tstrade/RoboFlock-Documentation/docs/source/hardware_docs/arduino.rst

Arduino Nano
============

.. include:: ../_templates/constants.rst

**Datasheet:** :raw-html:`<br />`
`Arduino Nano ATmega328 Microcontroller User Manual <nano_>`_

**Features:** 
16MHz Clock Frequency :raw-html:`<br />`
Digital, Analog, PWM, UART, I2C, and SPI Capabilities :raw-html:`<br />`
32kB Flash Memory :raw-html:`<br />`
2kB Internal SRAM :raw-html:`<br />`
1kB EEPROM :raw-html:`<br />`
Ideal for Constrained Spaces

**Connection:** :raw-html:`<br />`
Mini-B USB to USB Type-A 

**Interfacing:** :raw-html:`<br />`
`Arduino IDE <ide_>`_ 

**Dimensions (with headers):** :raw-html:`<br />`
43.2mm x 18mm x 18.5mm

**Use-Case:** :raw-html:`<br />`
Controls and processes data for all three :doc:`ultrasonic sensors <hc_sr04>`.

.. _nano: https://docs.arduino.cc/resources/datasheets/A000005-datasheet.pdf

.. _ide: https://docs.arduino.cc/software/ide/
