tstrade/RoboFlock-Documentation/docs/source/codebase_docs/codebase.rst

==================
RoboFlock Codebase
==================

.. toctree::
    :titlesonly:
    :hidden:
    :maxdepth: 1

    ultrasonic_code
    beacon_code
