tstrade/RoboFlock-Documentation/docs/source/citation_docs/glossary.rst

========
Glossary
========

.. include:: ../_templates/constants.rst

**GGA** - Global Positioning System Fix Data
:raw-html:`<br />`

**GLONASS** - Global Navigation Satellite System
:raw-html:`<br />`

**GNSS** - Global Navigation Satellite System
:raw-html:`<br />`

**GPS** - Global Positioning System
:raw-html:`<br />`

**IMU** - Inertial Measurement Unit
:raw-html:`<br />`

**LiDAR** - Light Detection and Ranging
:raw-html:`<br />`

**LoRa** - Long-Range Radio
:raw-html:`<br />`

**NMEA** - National Marine Electronics Association
:raw-html:`<br />`

**RF** - Radio Frequency
:raw-html:`<br />`

**ROS2** - Robot Operating System 2
:raw-html:`<br />`

**ToF** - Time-of-Flight
:raw-html:`<br />`
