tstrade/RoboFlock-Documentation/docs/source/citation_docs/appendix_b.rst

==========
Appendix B
==========

++++++++++
Datasheets
++++++++++

- `HC-12 Wireless RF UART Communication Module User Manual rev.2.4 <DS1_>`_

- `SLAMTEC RPLidar A1 Datasheet rev.2.1 <DS2_>`_

- `NVIDIA Jetson Orin Nano Series Modules Datasheet v1.5 <DS3_>`_

- `Jetson Nano Developer Kit User Guide v1.3 <DS4_>`_

- `Jetson Orin NX Series and Jetson Orin Nano Series Pin and Function Name Guide v1.0 <DS5_>`_

- `NEO-M8P-2 Datasheet <DS6_>`_

- `NEO-M8P-2 Hardware Integration Module <DS7_>`_

- `ANN-MB Series - Multi-Band, High Precision GNSS Antennas Datasheet rev.R05 <DS8_>`_

- `u-blox GNSS Multiband Antenna ANN-MB-00 (IP67) Datasheet <DS9_>`_

- `ZED-F9P-02B High-Precision GNSS Module (Professional Grade) Datasheet rev.R03 <DS10_>`_

- `LV-MaxSonar-EZ Series: High Performance Sonar Range Finder Datasheet <DS11_>`_

- `MAX17048/MAX17049 3uA 1-Cell/2-Cell Fuel Gauge with ModelGauge Datasheet rev.7 <DS12_>`_

- `Arduino Nano Datasheet rev.4 <DS13_>`_

- `iRhapsody 40/30A 12VDC Waterproof Relay Kit Instruction Manual <DS14_>`_

.. _DS1: https://statics3.seeedstudio.com/assets/file/bazaar/product/HC-12_english_datasheets.pdf

.. _DS2: https://cdn-shop.adafruit.com/product-files/4010/4010_datasheet.pdf

.. _DS3: https://developer.nvidia.com/downloads/assets/embedded/secure/jetson/orin_nano/docs/jetson_orin_nano_ds

.. _DS4: https://developer.nvidia.com/embedded/dlc/Jetson_Nano_Developer_Kit_User_Guide

.. _DS5: https://developer.nvidia.com/downloads/assets/embedded/secure/jetson/orin_nx/docs/jetson_orin_nx_orin_nano_pin_function_names_guide_da-11434-001_v1.0.pdf

.. _DS6: https://cdn.sparkfun.com/assets/2/f/6/8/3/NEO-M8P_DataSheet__UBX-15016656_.pdf

.. _DS7: https://cdn.sparkfun.com/assets/a/a/d/2/2/NEO-M8P_HardwareIntegrationManual__UBX-15028081_.pdf

.. _DS8: https://content.u-blox.com/sites/default/files/documents/ANN-MB_DataSheet_UBX-18049862.pdf

.. _DS9: https://www.ardusimple.com/wp-admin/admin-post.php?action=generate_product_pdf&product_id=3127 

.. _DS10: https://cdn.sparkfun.com/assets/f/8/d/6/d/ZED-F9P-02B_DataSheet_UBX-21023276.pdf

.. _DS11: https://cdn.shopify.com/s/files/1/0550/8091/0899/files/11832.pdf?v=1726578772

.. _DS12: https://www.analog.com/media/en/technical-documentation/data-sheets/max17048-max17049.pdf

.. _DS13: https://docs.arduino.cc/resources/datasheets/A000005-datasheet.pdf

.. _DS14: https://manuals.plus/asin/B074FSZWVT 

Schematics
^^^^^^^^^^

- `Qwiic GPS-RTK-SMA - u-blox ZED-F9P Schematic v12  <SC1_>`_

- `Qwiic GPS-RTK - u-blox NEO-M8P Schematic v10 <SC2_>`_

- `SLAMTEC RPLiDAR A1M8 Core Schematic <SC3_>`_

.. _SC1: https://cdn.sparkfun.com/assets/6/5/7/6/6/SparkFun-GPS-RTK-SMA-ZED-F9P-Schematic.pdf

.. _SC2: https://cdn.sparkfun.com/assets/f/f/5/c/8/Qwiic_GPS-RTK_-_ublox_NEO-M8P.pdf

.. _SC3: https://bucket-download.slamtec.com/fb0b36f64212432b51a8e078081f168f39b96a49/RPLIDAR%20A1M8_en.pdf
