tstrade/RoboFlock-Documentation/docs/source/description_docs/future_considerations.rst

Future Considerations
=====================

Return home functionality

Replace NEO with ZED

Location broadcasting

L5 GPS

4D LiDAR

Nvidia (ISAAC) ROS 2 Projects
