tstrade/RoboFlock-Documentation/docs/source/citation_docs/mathref_docs/kalmanfilters.rst

================
Kalman Filtering
================

Kalman Filter
+++++++++++++

Extended Kalman Filter
++++++++++++++++++++++

Unscented Kalman Filter
+++++++++++++++++++++++
