tstrade/RoboFlock-Documentation/docs/source/contact.rst

==========
Contact Us
==========

.. grid:: 2 2 3 4
    :gutter: 3

    .. grid-item-card::
        :class-title: sd-text-center
        :class-card: sd-shadow-sm

        **Thomas Strade** 
        ^^^
        *Primary Maintainer*
        +++
        📧 tstrade@buffalo.edu

        🐱 `@tstrade <https://github.com/tstrade>`_

    .. grid-item-card::
        :class-title: sd-text-center
        :class-card: sd-shadow-sm

        **Aditya Challamarad** 
        ^^^
        *Software Lead*
        +++
        🐱 `@Adityasc9 <https://github.com/Adityasc9>`_

    .. grid-item-card::
        :class-title: sd-text-center
        :class-card: sd-shadow-sm

        **Marco Bianco** 
        ^^^
        *Integration Lead*
        +++
        🐱 `@marcobia <https://github.com/Marcob1129>`_

    .. grid-item-card::
        :class-title: sd-text-center
        :class-card: sd-shadow-sm

        **Nicholas Pitsakis** 
        ^^^
        *Communications Lead*
        +++
        🐱 `@npitsakis <https://github.com/npitsakis>`_

    .. grid-item-card::
        :class-title: sd-text-center
        :class-card: sd-shadow-sm

        **Krish Puwar** 
        ^^^
        *Support Lead*
        +++
        🐱 `@krishpuw <https://github.com/krishpuw>`_

    .. grid-item-card::
        :class-title: sd-text-center
        :class-card: sd-shadow-sm

        **Shouvik Das** 
        ^^^
        *Testing Lead*
        +++
        🐱 `@shouvik-d <https://github.com/shouvik-d>`_

    .. grid-item-card::
        :class-title: sd-text-center
        :class-card: sd-shadow-sm

        **Andrew Collado** 
        ^^^
        *Design Lead*
        +++
        🐱 `@AndrewCollado <https://github.com/AndrewCollado>`_

.. admonition:: Get in Touch
    :class: tip

    - 🐛 **Report bugs or request features**: Open an issue on our `GitHub <https://github.com/shouvik-d/roboflock_ws>`_

    - 💬 **General quesions**: Email the primary maintainer
    
    - 📚 **Academic inquiries**: Contact the project lead
