tstrade/RoboFlock-Documentation/docs/source/photo_video.rst

================
Photo and Videos
================

.. include:: _templates/constants.rst

Isn't engineering just so... fun?

.. @todo: switch to sphinx-design, carousel was archived in 2024

.. carousel::
    :show_controls:

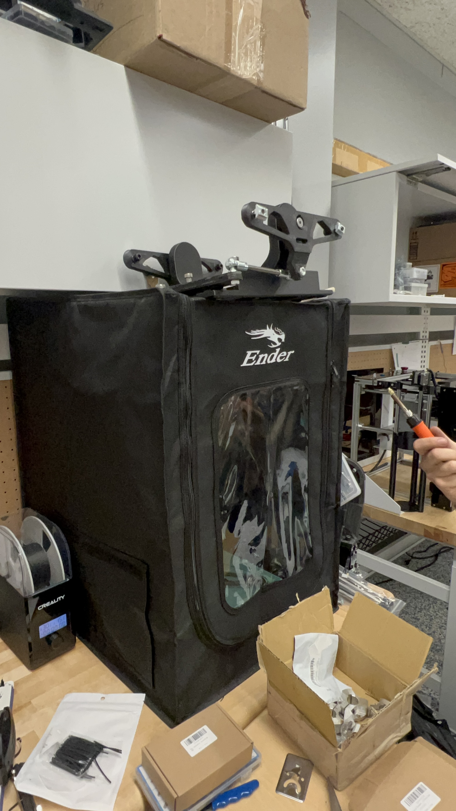
[picture p10: docs/source/_images/progress_album/IMG_5511.jpg]
    

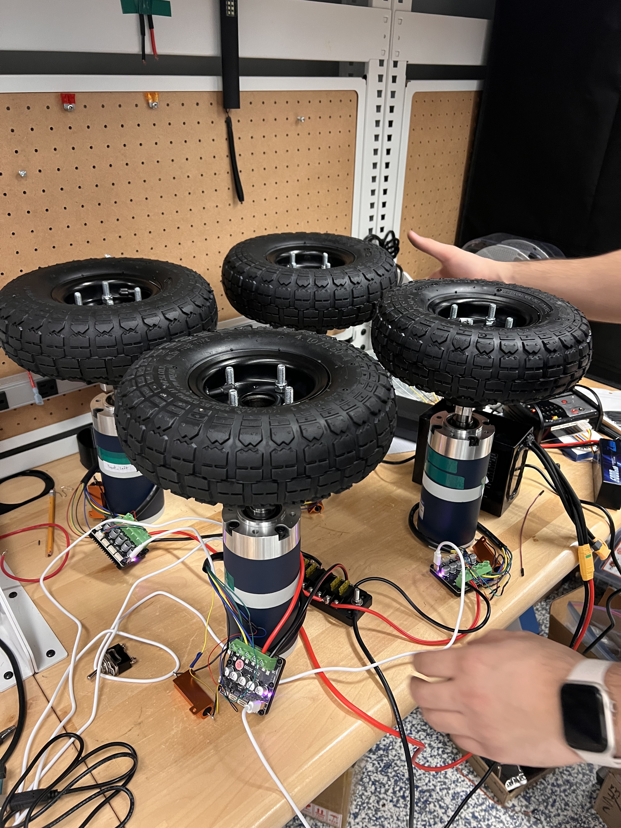
[picture p11: docs/source/_images/progress_album/IMG_5522.jpg]
    

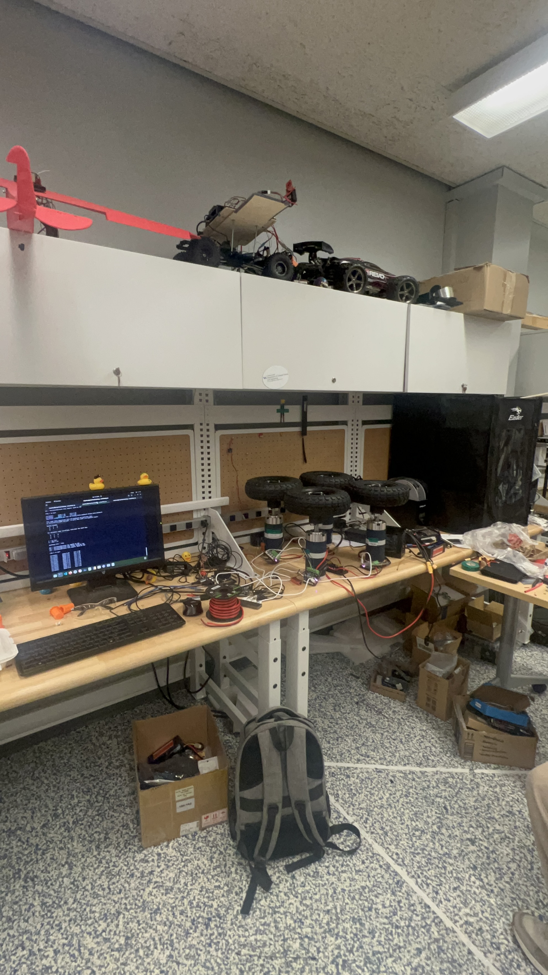
[picture p12: docs/source/_images/progress_album/IMG_5525.jpg]
    

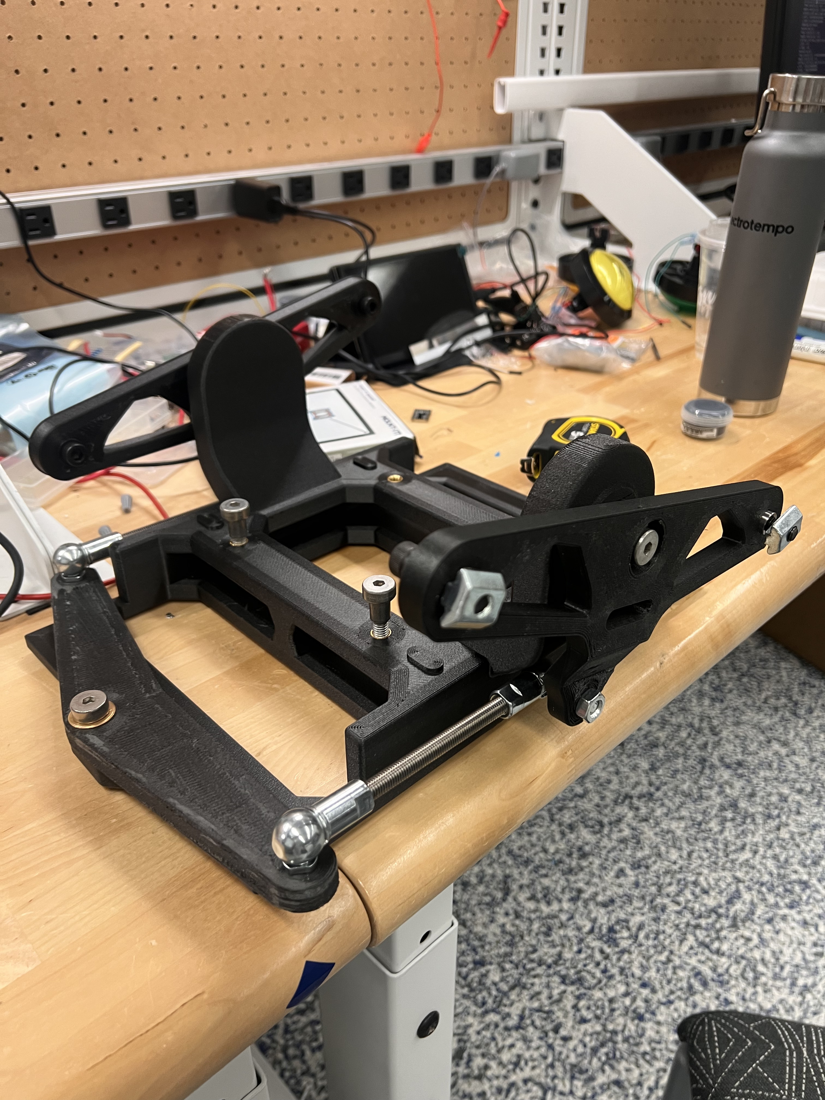
[picture p13: docs/source/_images/progress_album/IMG_5531.jpg]
    

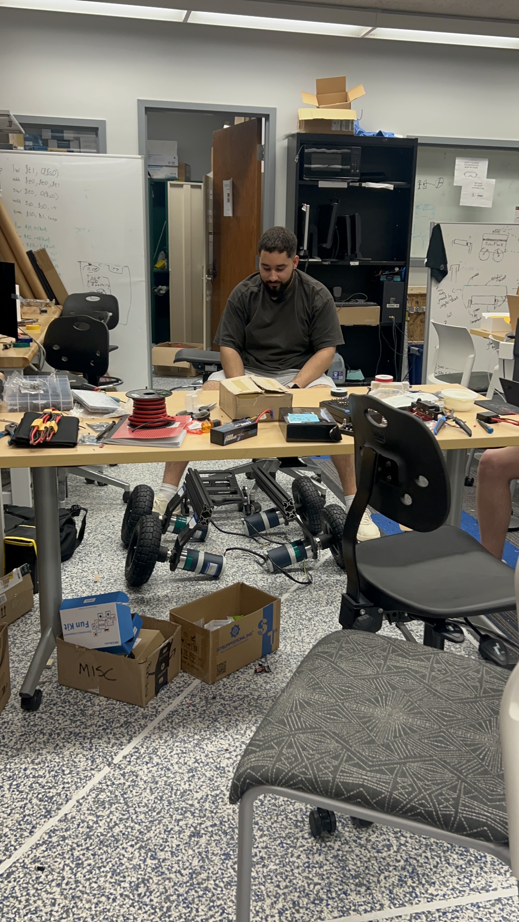
[picture p14: docs/source/_images/progress_album/IMG_5537.jpg]
    

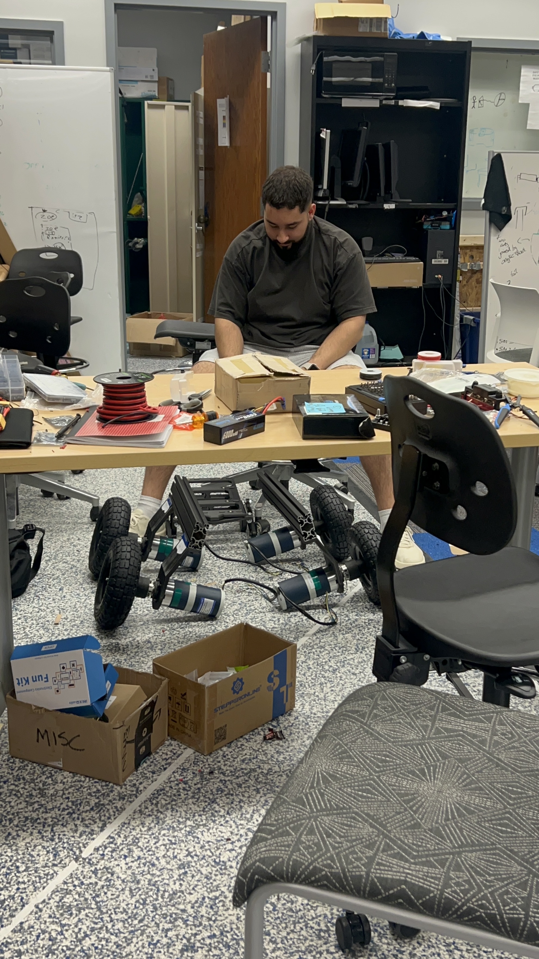
[picture p15: docs/source/_images/progress_album/IMG_5538.jpg]
    

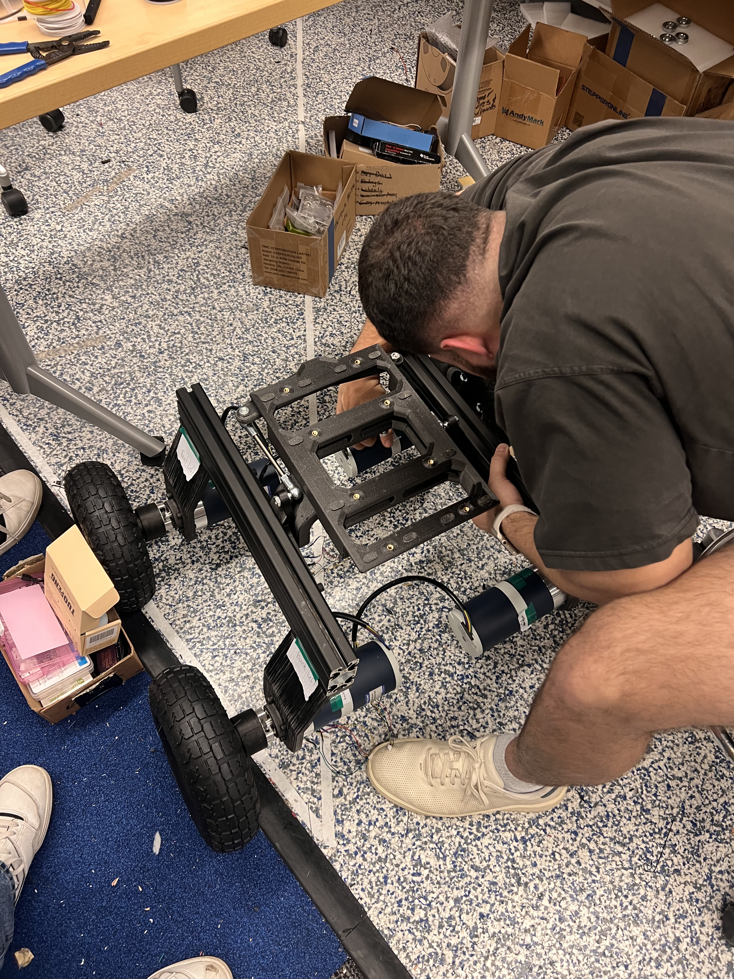
[picture p16: docs/source/_images/progress_album/IMG_5540.jpg]
    

    

    

    

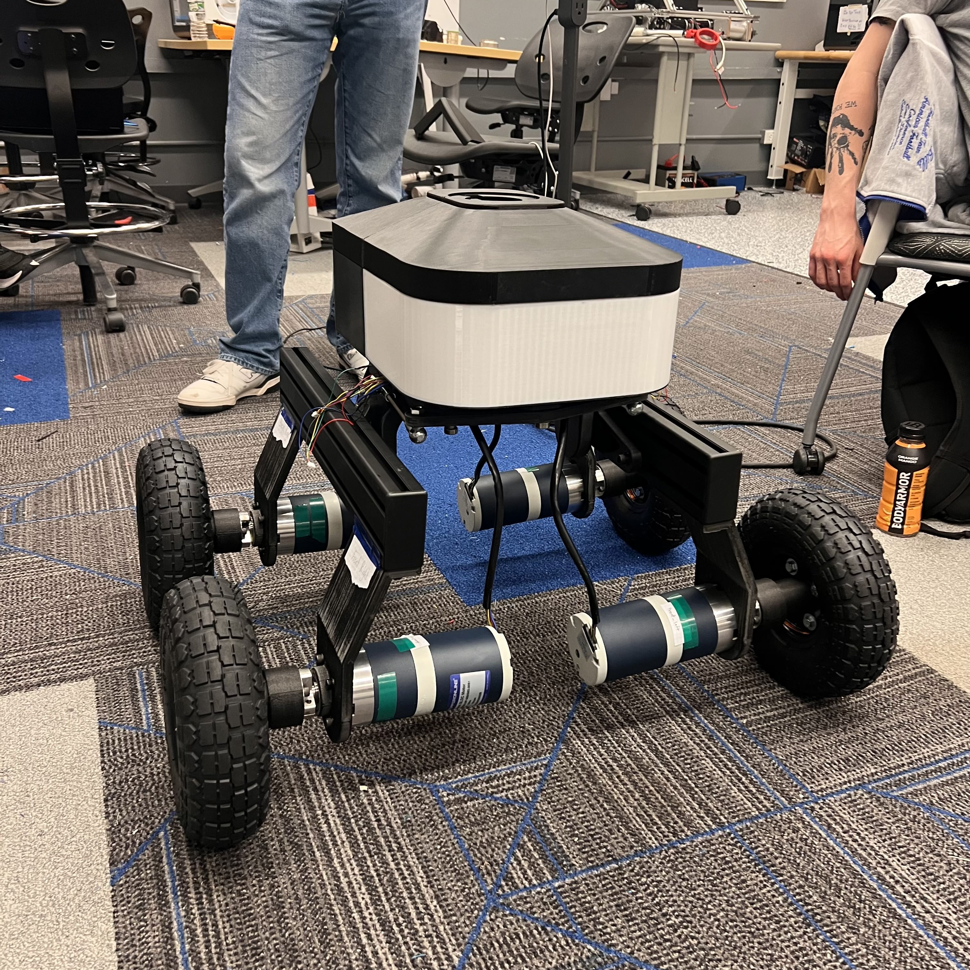
[picture p20: docs/source/_images/progress_album/IMG_5554.jpg]
    

    

    

    

    

    

    

    

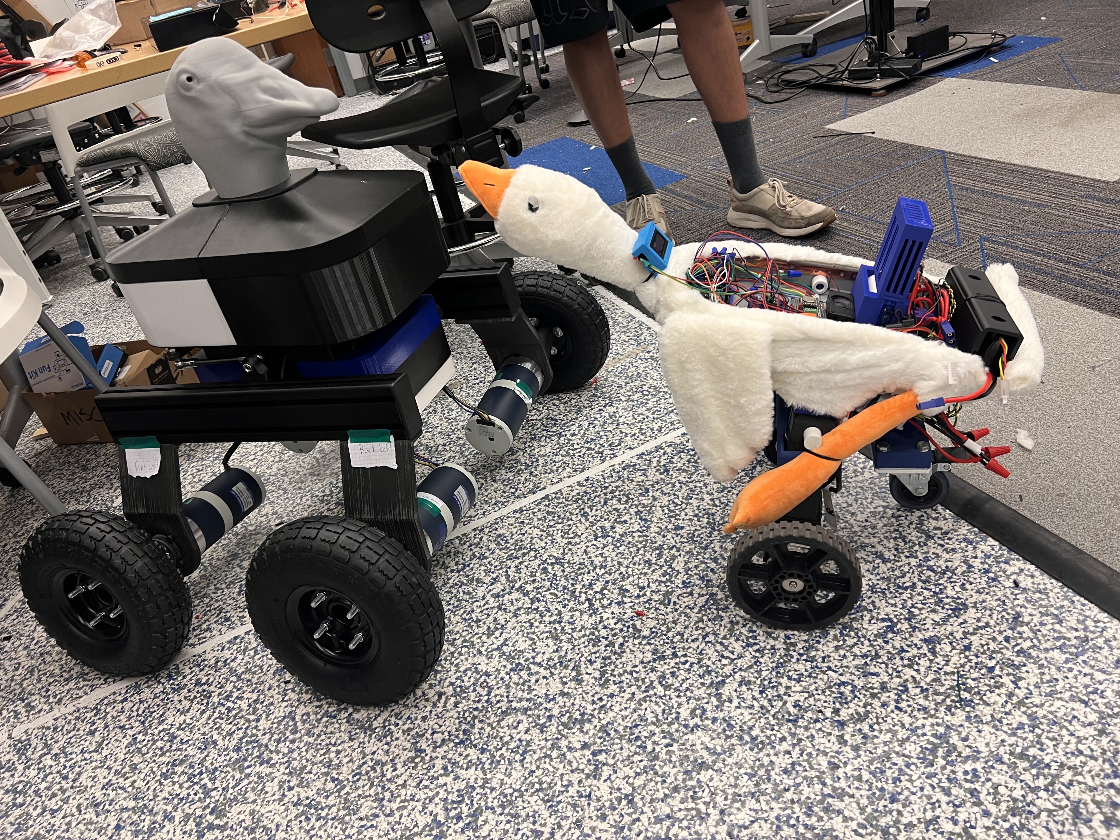
[picture p28: docs/source/_images/progress_album/IMG_5609.jpg]
    

    

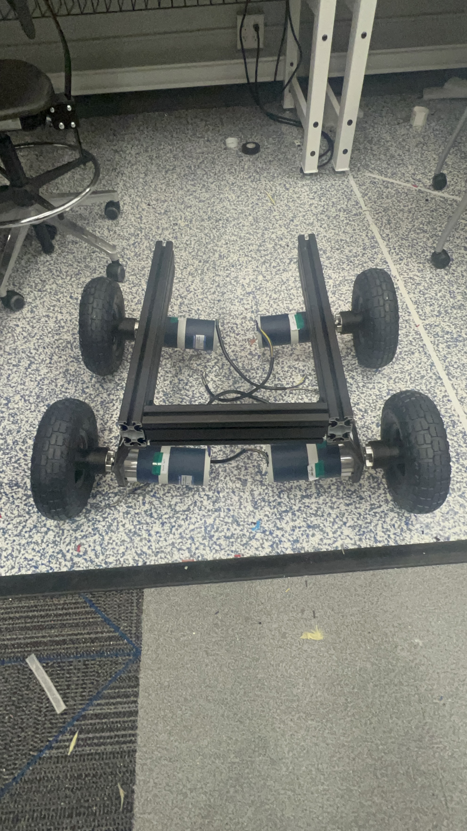
[picture p30: docs/source/_images/progress_album/IMG_5711.jpg]
    

    

    

    

    

    

    

    

    

    

    

.. video:: _static/videos/IMG_5514.mp4
    :preload: auto
    :align: center
    :nocontrols:
    :autoplay:
    :playsinline:
    :muted:
    :loop:

:raw-html:`<br />`

.. video:: _static/videos/IMG_5523.mp4
    :preload: auto
    :align: center
    :nocontrols:
    :autoplay:
    :playsinline:
    :muted:
    :loop:

:raw-html:`<br />`

.. video:: _static/videos/IMG_5524.mp4
    :preload: auto
    :align: center
    :nocontrols:
    :autoplay:
    :playsinline:
    :muted:
    :loop:

:raw-html:`<br />`
    
.. video:: _static/videos/IMG_5713.mp4
    :preload: auto
    :align: center
    :nocontrols:
    :autoplay:
    :playsinline:
    :muted:
    :loop:
