tstrade/RoboFlock-Documentation/docs/source/citation_docs/additional_info.rst

======================
Additional Information
======================

- :doc:`Component List <appendix_a>`

- :doc:`Datasheets and Schematics <appendix_b>`

- :doc:`Glossary <glossary>`

- :doc:`Bibliography <bibliography>`

- :doc:`Mathematics References <mathref_docs/mathref>`

.. toctree::
    :hidden:
    :titlesonly:
    :maxdepth: 1

    appendix_a
    appendix_b
    glossary
    bibliography
    mathref_docs/mathref
