tstrade/RoboFlock-Documentation/docs/source/_images/fig4-1_sonar_phys_design.png

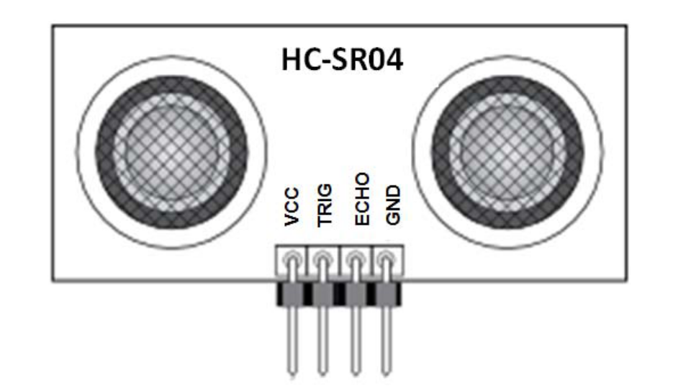
docs/source/_images/fig4-1_sonar_phys_design.png
