tstrade/RoboFlock-Documentation/docs/source/_images/Robo.png

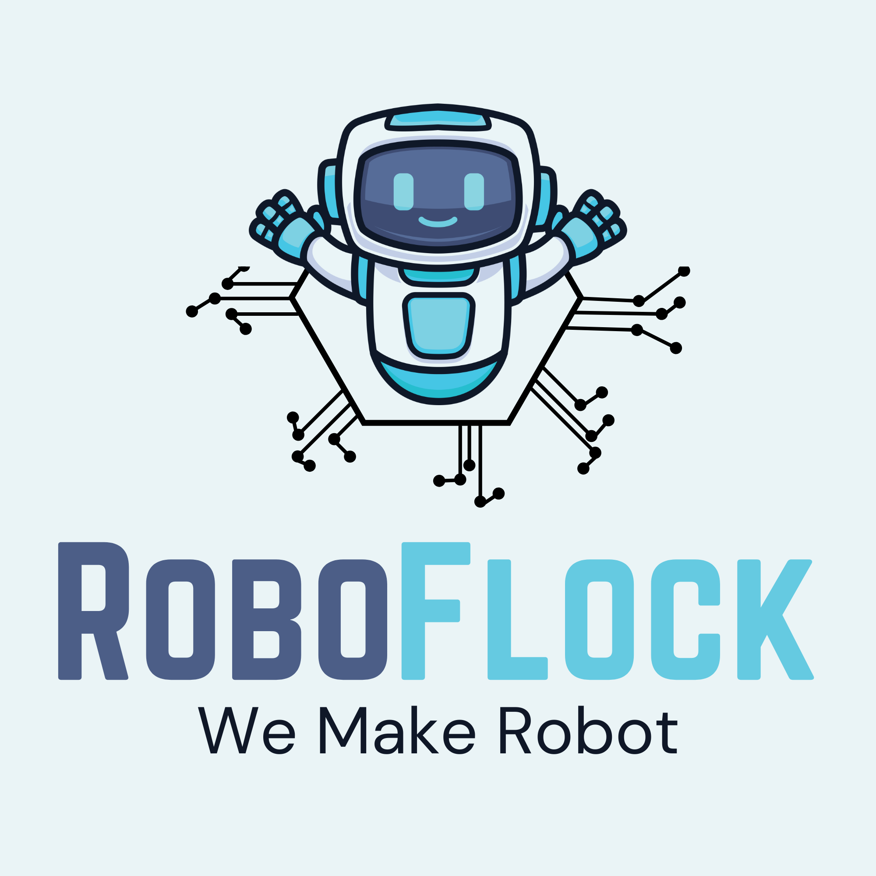
docs/source/_images/Robo.png
