tstrade/RoboFlock-Documentation/(list of files, cad)

Other CAD files:
docs/blobs/mechanical/meshes/Differential Arm.stl
docs/blobs/mechanical/fusion/Differential Arm.f3d
