tstrade/RoboFlock-Documentation/docs/source/construction_docs/wiring_specifications.rst

=====================
Wiring Specifications
=====================

Motor System
++++++++++++

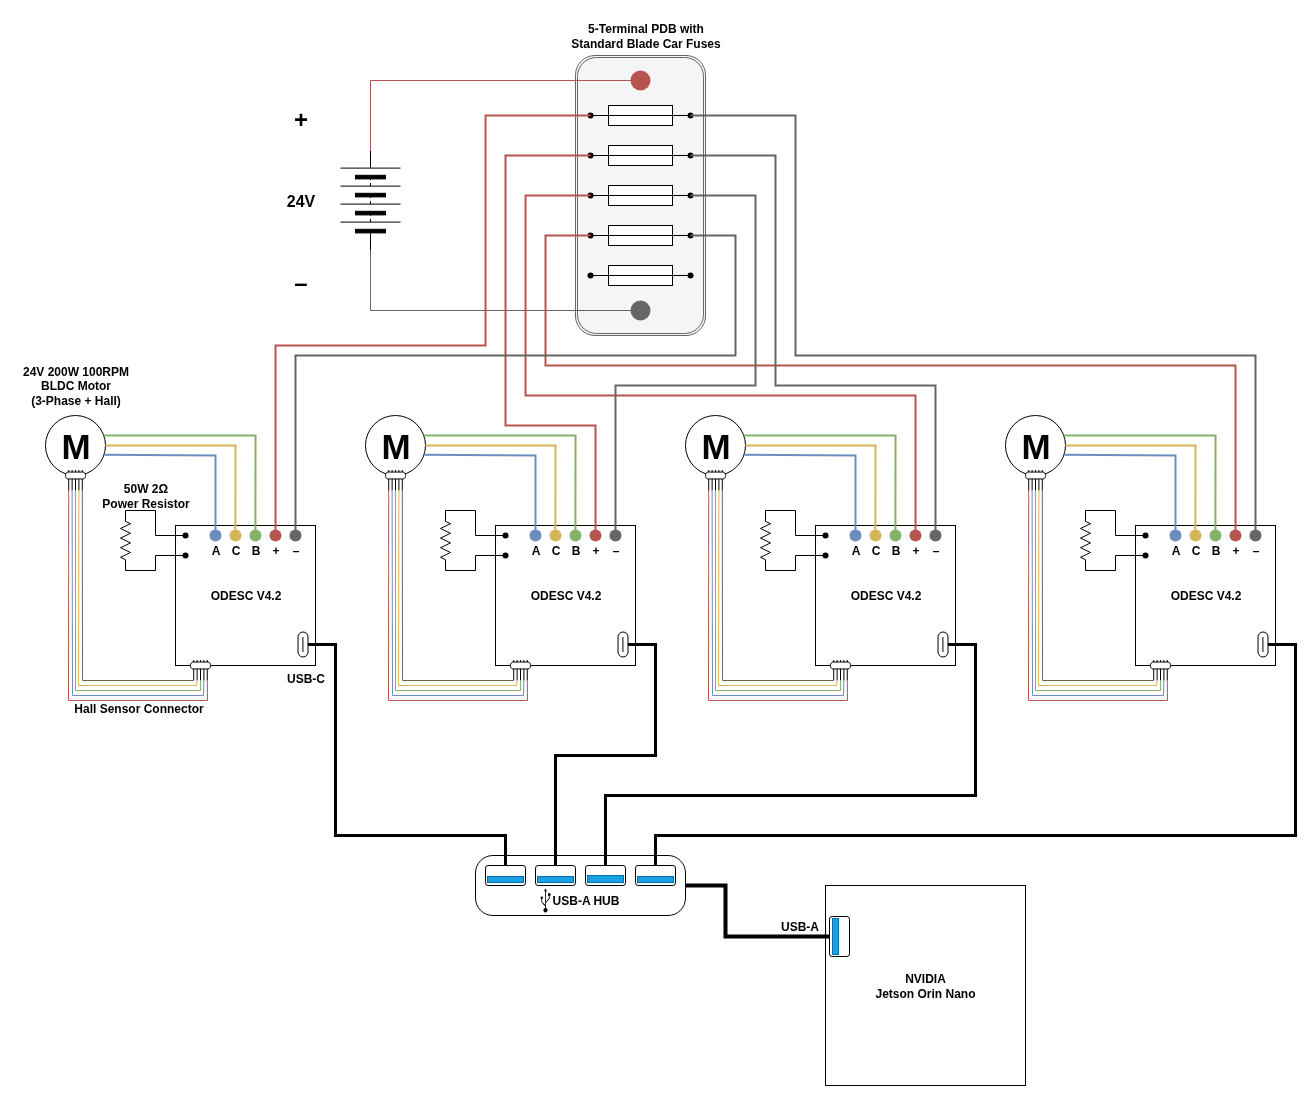
[picture p43: docs/source/_images/wiring_diagrams/MotorSystemWiring.png]


-------------------------------

Obstacle Detection System
+++++++++++++++++++++++++

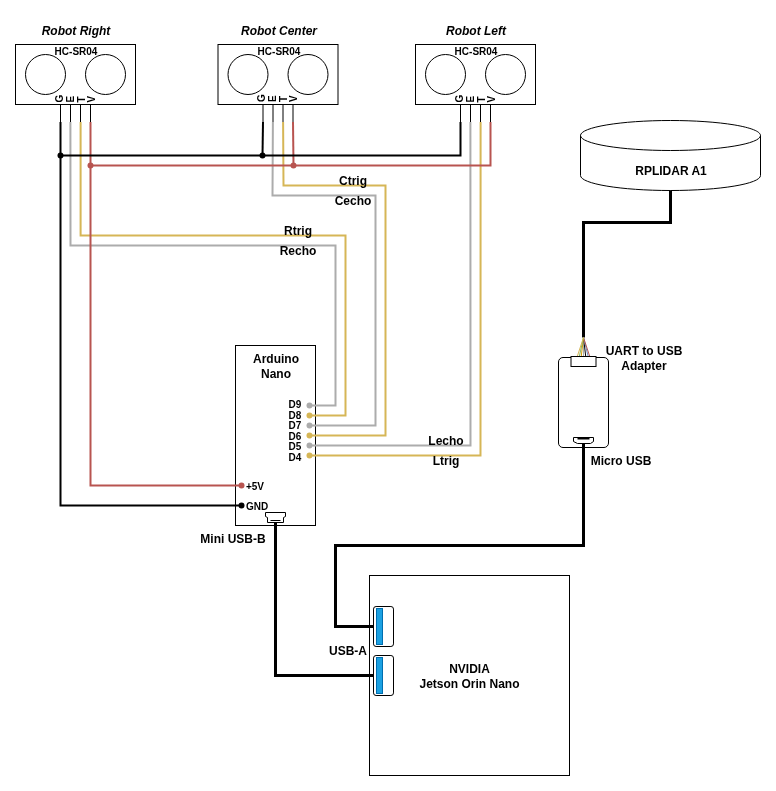
[picture p44: docs/source/_images/wiring_diagrams/ObstacleDetectSystemWiring.png]
