tstrade/RoboFlock-Documentation/docs/source/getting_started_docs/getting_started.rst

===============
Getting Started
===============

- :doc:`Setting up the Nvidia Jetson Orin Nano <jetson_config>`

- :doc:`Installation Guide <install_guide>`

- :doc:`GPS Module Configuration <gps_config>`

- :doc:`Meshtastic Configuration <meshtastic_config>`

- :doc:`GPS Visualization Setup <visuals_setup>`

- :doc:`ODESC V4.2 Motor Configuration and Setup <odesc>`

- :doc:`Managing USB Devices <manage_usb>`

.. toctree::
    :hidden:
    :maxdepth: 2

    jetson_config
    install_guide
    gps_config
    meshtastic_config
    visuals_setup
    odesc
    manage_usb
