tstrade/RoboFlock-Documentation/docs/source/tutorial_docs/tutorials.rst

=========
Tutorials
=========

A quick guide to RoboFlock's internal mechanisms and how to use, edit, and run the project.

- :doc:`Writing CML Files <cmakelists>`

- :doc:`Using RoboFlock's Topics <roboflock_topics>`

- :doc:`Troubleshooting and Debugging <debugging/website_debug>`

- :doc:`Making Launch Files <website_launch>`

- :doc:`Creating the URDF <website_urdf>`

- :doc:`Working with Nav2 <website_nav2>`

.. toctree::
    :hidden:
    :maxdepth: 2

    cmakelists
    roboflock_topics
    debugging/website_debug
    website_launch
    website_urdf
    website_nav2
