tstrade/RoboFlock-Documentation/docs/source/_images/wiring_diagrams/JetsonHeaders.png

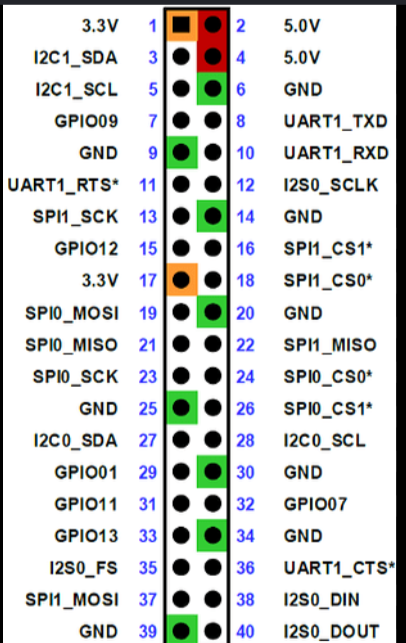
docs/source/_images/wiring_diagrams/JetsonHeaders.png
