tstrade/RoboFlock-Documentation/(commit log)

2025-12-18 Switch image from embed to link. Added outline of each section as .rst
2025-12-18 Added .png of all current figures
2025-12-19 Finished transferring all current documentation
2026-01-12 Add Jetson Config instructions and nav topic descriptions
2026-02-24 Finished ultrasonic codebase doc
2026-03-15 Fix ultrasonic and software diagram images
2026-05-01 Add catalogs and hull \ frame docs
2026-05-04 Add blobs
    [Differential Arm.f3d, Differential Arm.stl]
2026-05-06 Add construction files
    [RV1-CHS-001_Frame.f3d, RV1-CHS-001_Frame.stl, RV1-DRV-BKT-001_Motor_Bracket.f3d, RV1-DRV-BKT-001_Motor_Bracket.stl, RV1-ELE-BKT-001_Lidar_Holder.f3d, RV1-ELE-BKT-001_Lidar_Holder.stl, RV1-ELE-BKT-002_Ultrasonic_Sensor_Mount.f3d, RV1-ELE-BKT-002_Ultrasonic_Sensor_Mount.stl]
2026-05-06 Fix construction files
    [RV1-CHS-001_Frame.f3d, RV1-CHS-001_Frame.stl, RV1-DRV-BKT-001_Motor_Bracket.f3d, RV1-DRV-BKT-001_Motor_Bracket.stl, RV1-ELE-BKT-001_Lidar_Holder.f3d, RV1-ELE-BKT-001_Lidar_Holder.stl, RV1-ELE-BKT-002_Ultrasonic_Sensor_Mount.f3d, RV1-ELE-BKT-002_Ultrasonic_Sensor_Mount.stl]
2026-05-20 Add wiring diagrams and Nav2 explanation
2026-05-23 Added launch, nav2, and URDF tutorials
    [RV1-CHS-001_Frame.f3d, RV1-CHS-001_Frame.stl, RV1-DRV-BKT-001_Motor_Bracket.f3d, RV1-DRV-BKT-001_Motor_Bracket.stl, RV1-ELE-BKT-001_Lidar_Holder.f3d, RV1-ELE-BKT-001_Lidar_Holder.stl, RV1-ELE-BKT-002_Ultrasonic_Sensor_Mount.f3d, RV1-ELE-BKT-002_Ultrasonic_Sensor_Mount.stl]
