tstrade/RoboFlock-Documentation/docs/build/html/_images/IMG_5545.jpg

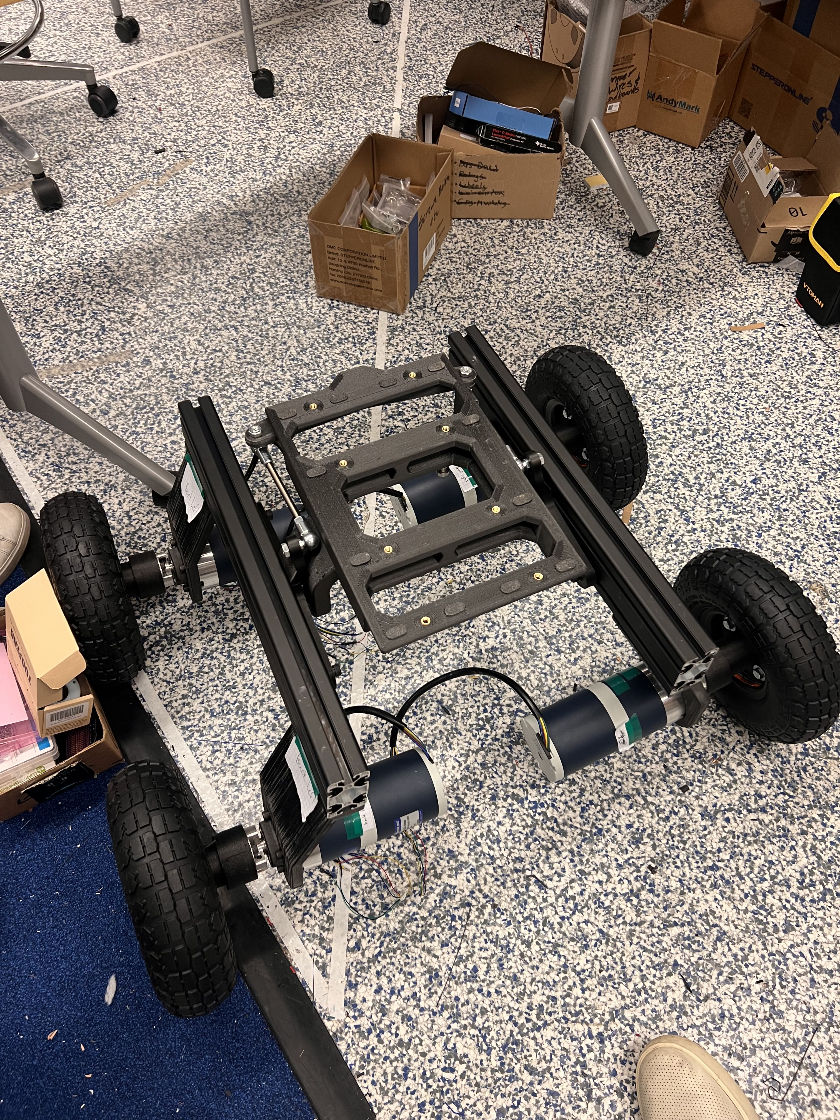
[picture p17: docs/source/_images/progress_album/IMG_5545.jpg]
docs/build/html/_images/IMG_5545.jpg
