tstrade/RoboFlock-Documentation/docs/build/html/_images/IMG_5548.jpg

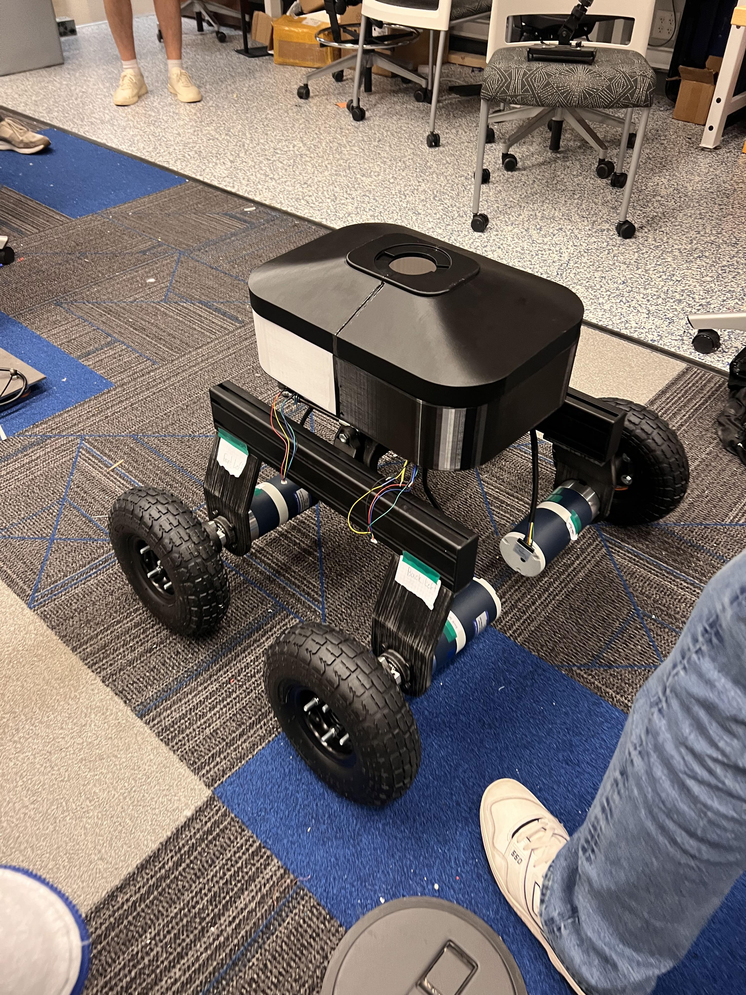
[picture p18: docs/source/_images/progress_album/IMG_5548.jpg]
docs/build/html/_images/IMG_5548.jpg
