tstrade/RoboFlock-Documentation/docs/build/html/_images/IMG_5550.jpg

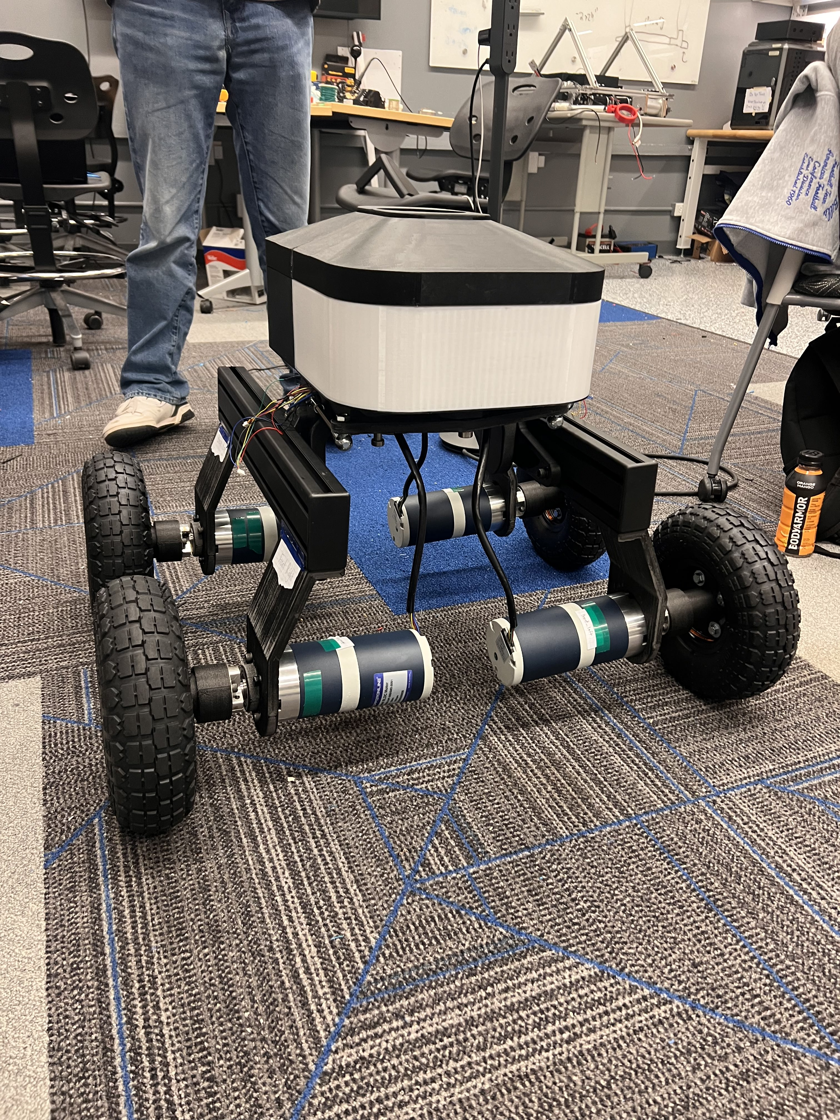
[picture p19: docs/source/_images/progress_album/IMG_5550.jpg]
docs/build/html/_images/IMG_5550.jpg
