tstrade/RoboFlock-Documentation/docs/build/html/_images/IMG_5565.jpg

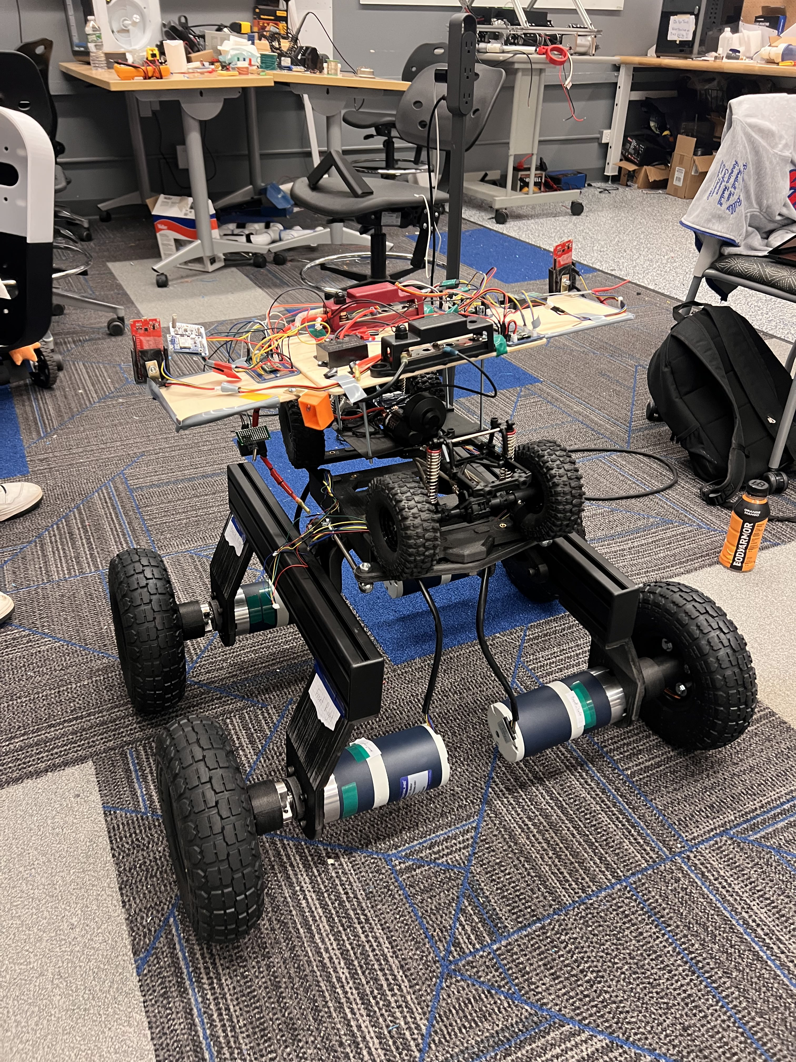
[picture p21: docs/source/_images/progress_album/IMG_5565.jpg]
docs/build/html/_images/IMG_5565.jpg
