tstrade/RoboFlock-Documentation/docs/build/html/_images/IMG_5581.jpg

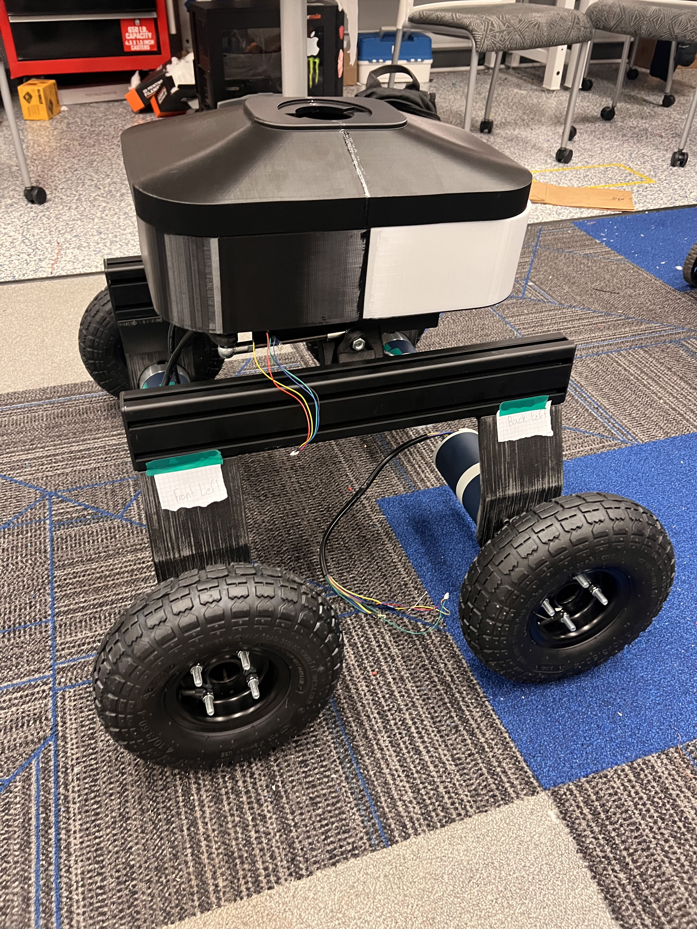
[picture p22: docs/source/_images/progress_album/IMG_5581.jpg]
docs/build/html/_images/IMG_5581.jpg
