tstrade/RoboFlock-Documentation/docs/build/html/_images/IMG_5592.jpg

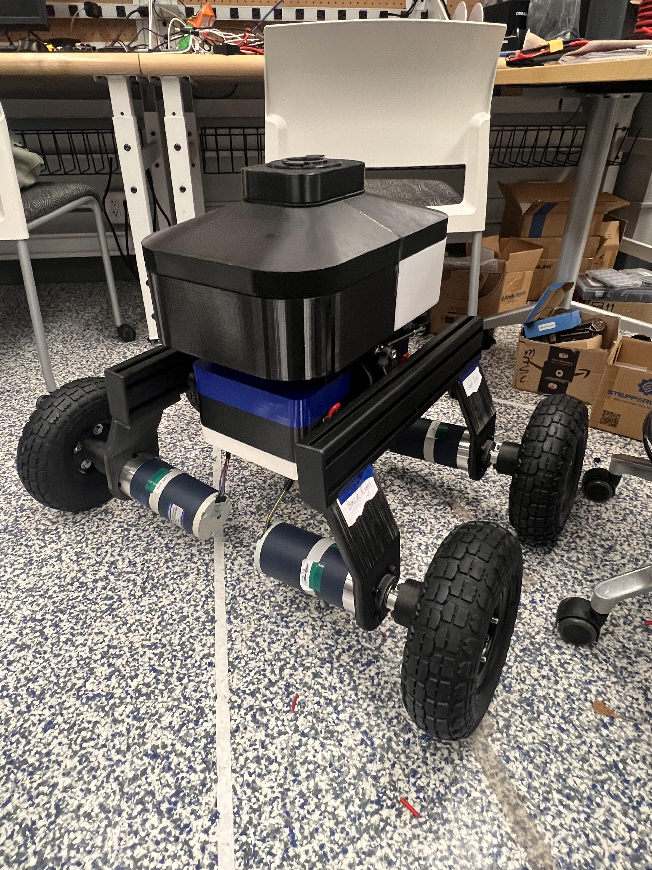
[picture p23: docs/source/_images/progress_album/IMG_5592.jpg]
docs/build/html/_images/IMG_5592.jpg
