tstrade/RoboFlock-Documentation/docs/build/html/_images/IMG_5594.jpg

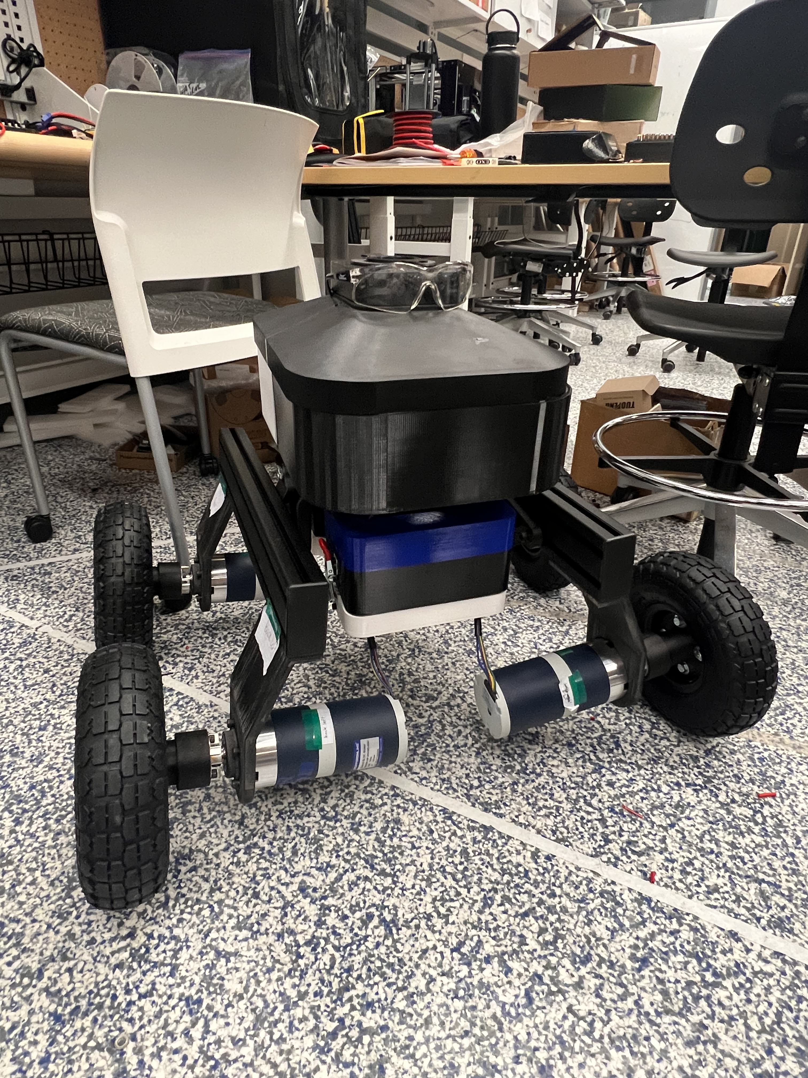
[picture p24: docs/source/_images/progress_album/IMG_5594.jpg]
docs/build/html/_images/IMG_5594.jpg
