tstrade/RoboFlock-Documentation/docs/build/html/_images/IMG_5595.jpg

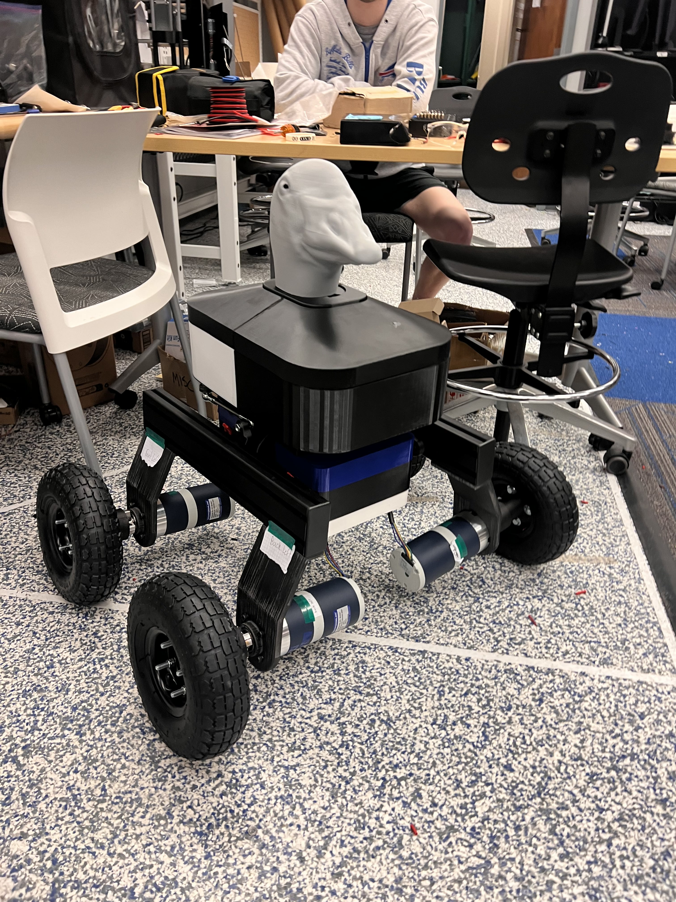
[picture p25: docs/source/_images/progress_album/IMG_5595.jpg]
docs/build/html/_images/IMG_5595.jpg
