tstrade/RoboFlock-Documentation/docs/build/html/_images/IMG_5598.jpg

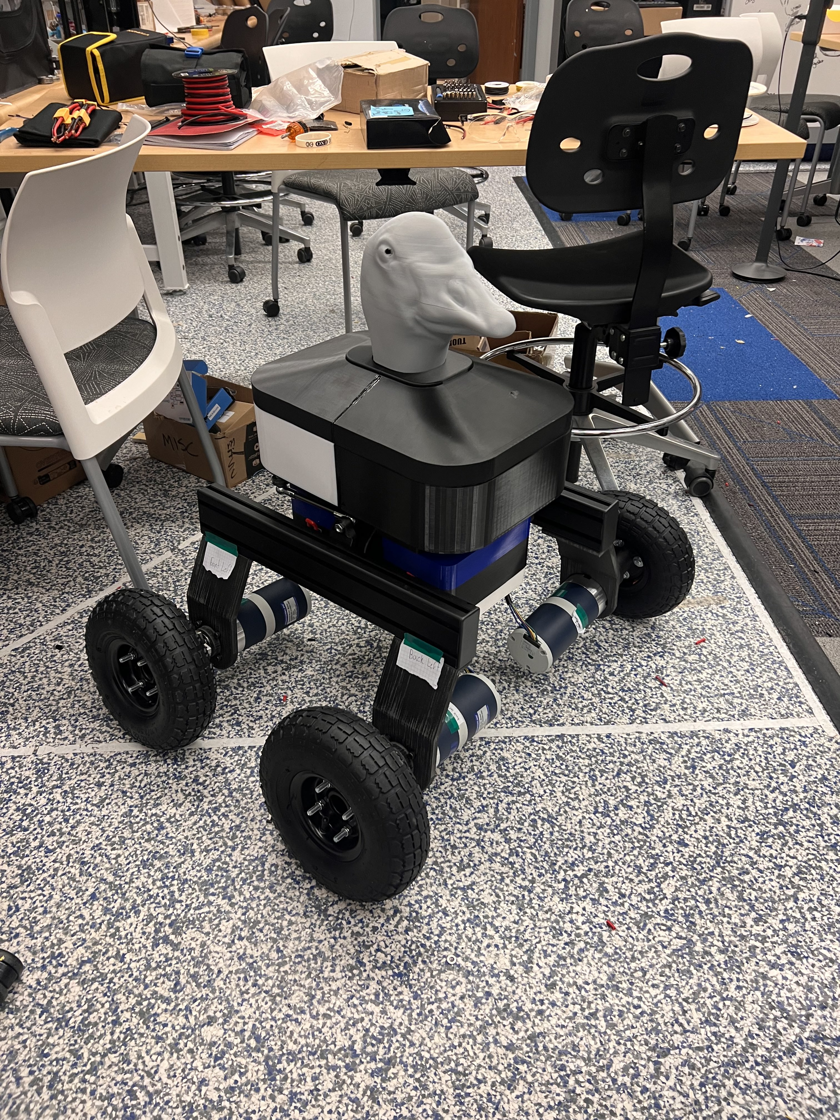
[picture p26: docs/source/_images/progress_album/IMG_5598.jpg]
docs/build/html/_images/IMG_5598.jpg
