tstrade/RoboFlock-Documentation/docs/build/html/_images/IMG_5600.jpg

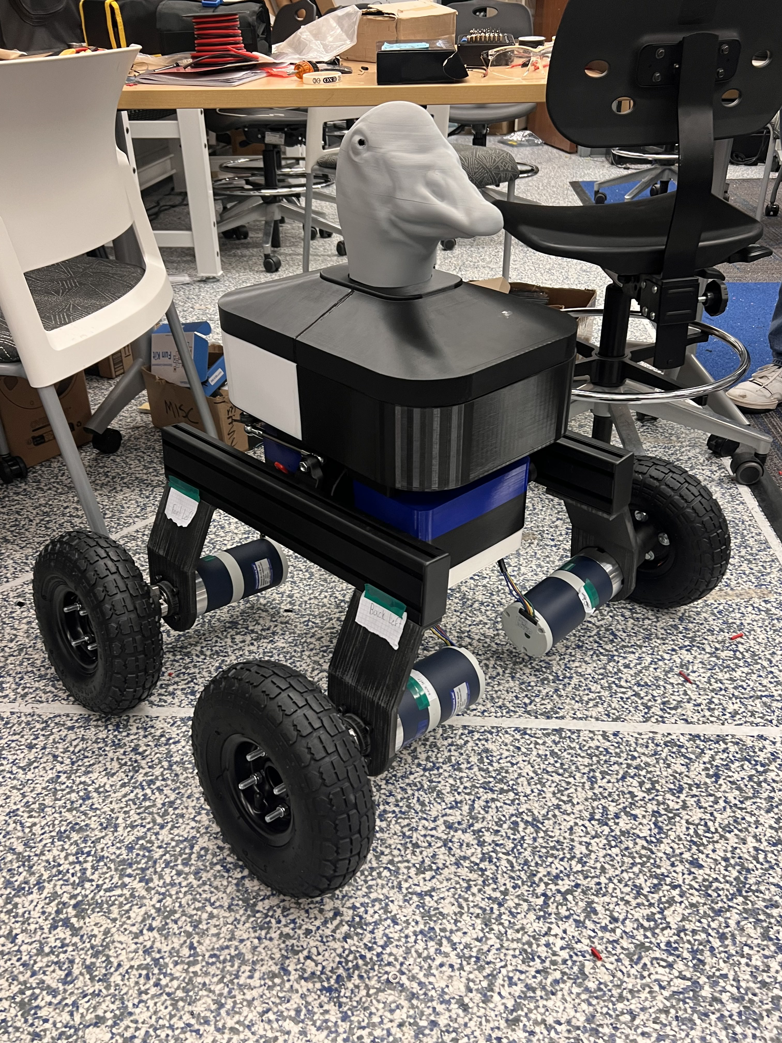
[picture p27: docs/source/_images/progress_album/IMG_5600.jpg]
docs/build/html/_images/IMG_5600.jpg
