tstrade/RoboFlock-Documentation/docs/build/html/_images/IMG_5708.jpg

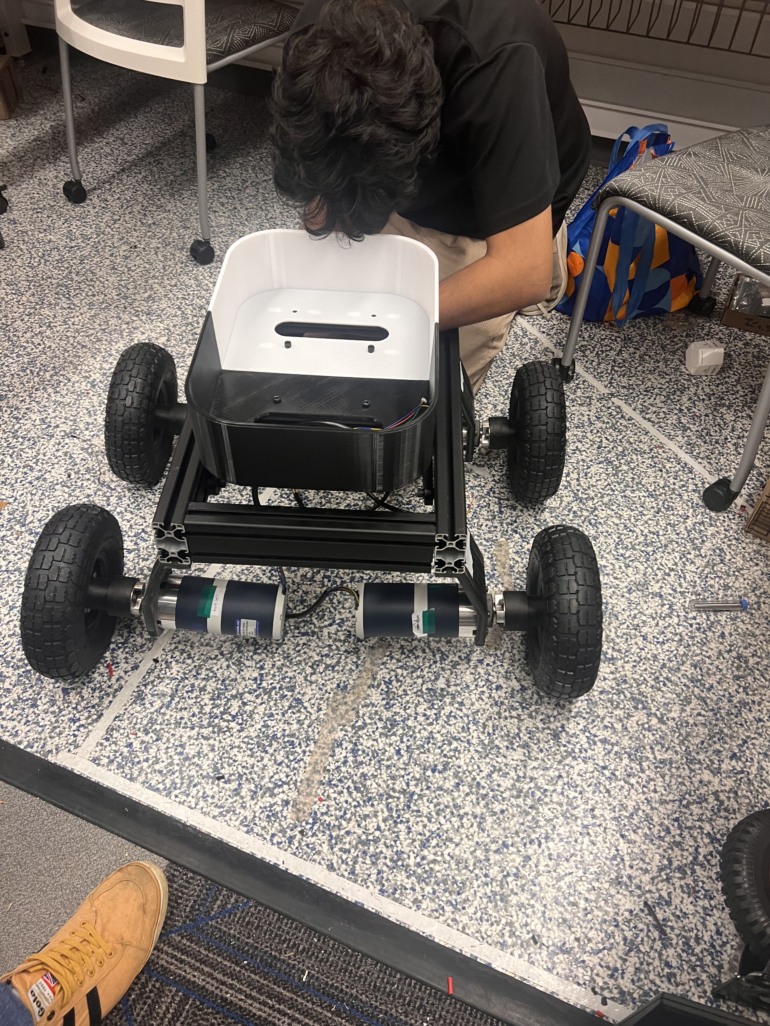
[picture p29: docs/source/_images/progress_album/IMG_5708.jpg]
docs/build/html/_images/IMG_5708.jpg
