tstrade/RoboFlock-Documentation/docs/build/html/_images/IMG_5720.jpg

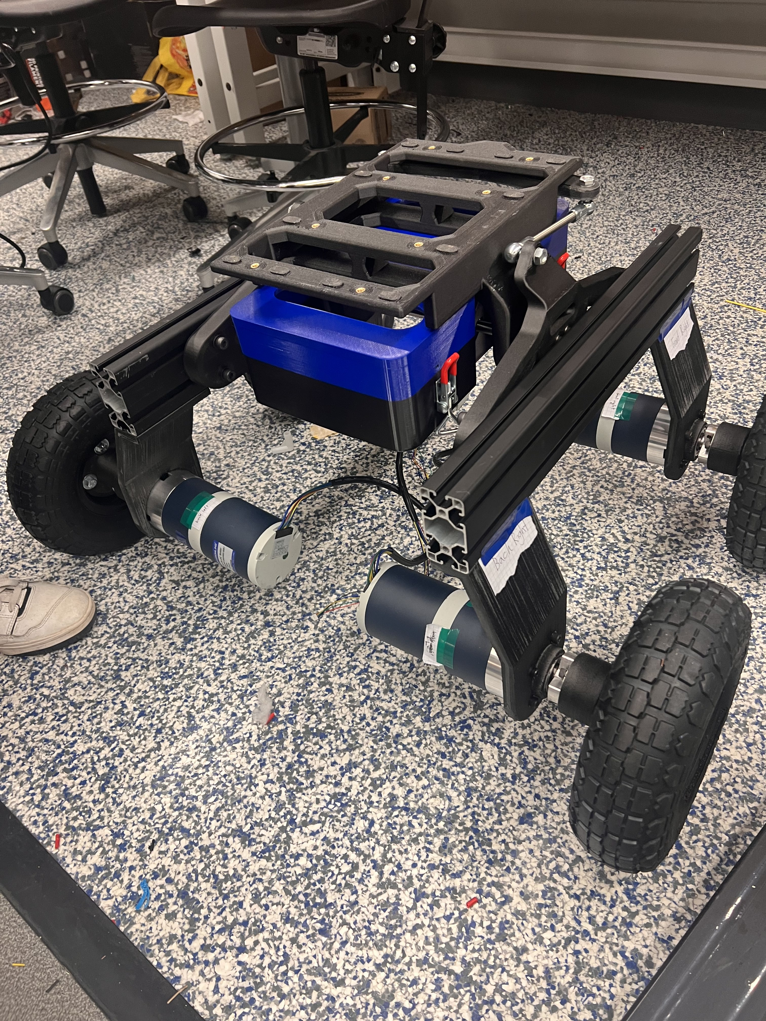
[picture p31: docs/source/_images/progress_album/IMG_5720.jpg]
docs/build/html/_images/IMG_5720.jpg
