tstrade/RoboFlock-Documentation/docs/build/html/_images/IMG_5721.jpg

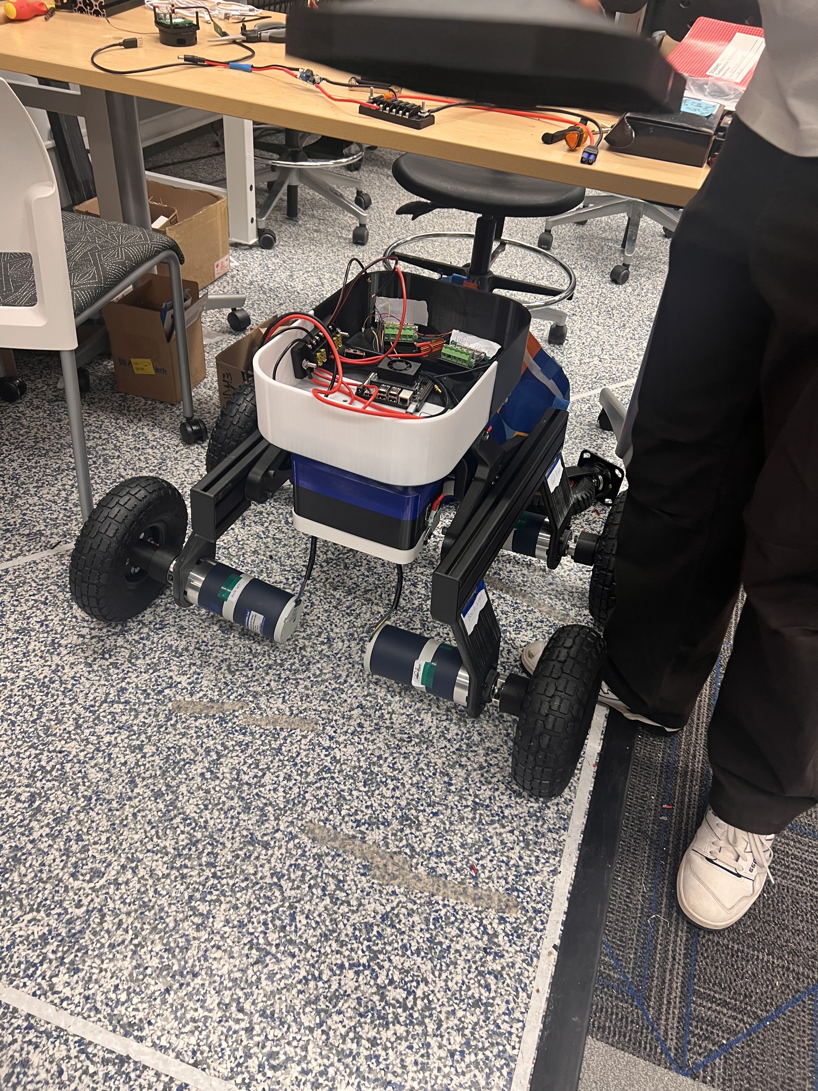
[picture p32: docs/source/_images/progress_album/IMG_5721.jpg]
docs/build/html/_images/IMG_5721.jpg
