tstrade/RoboFlock-Documentation/docs/build/html/_images/IMG_5723.jpg

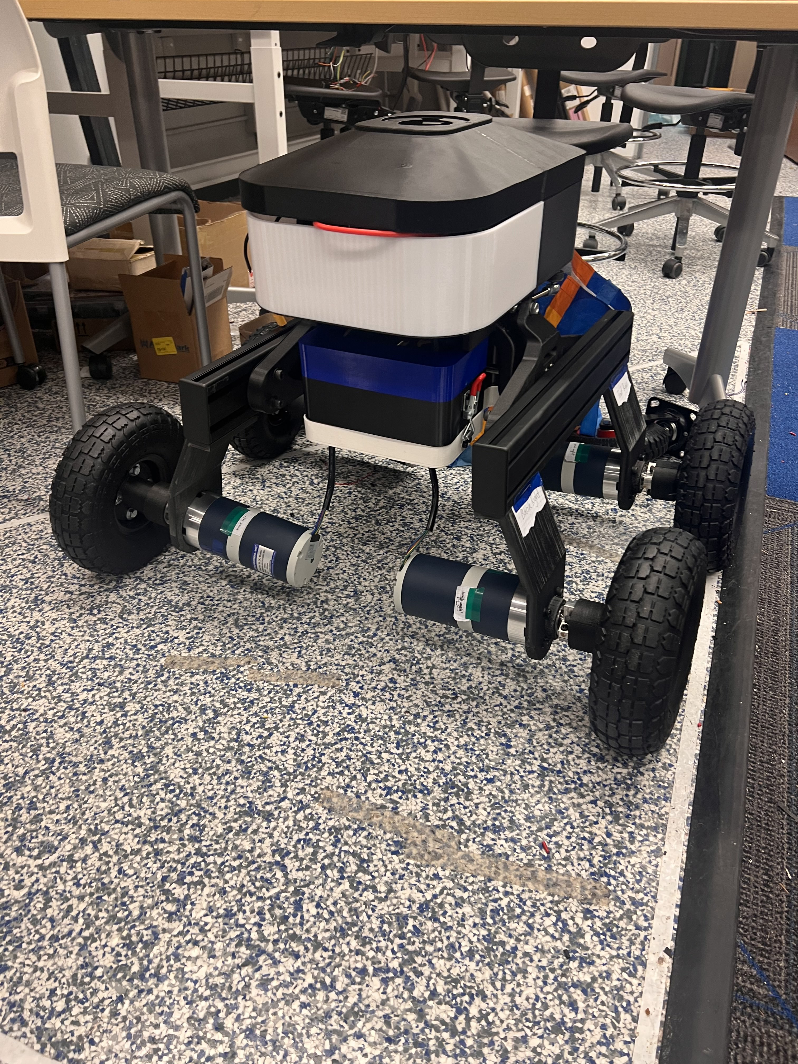
[picture p33: docs/source/_images/progress_album/IMG_5723.jpg]
docs/build/html/_images/IMG_5723.jpg
