tstrade/RoboFlock-Documentation/docs/build/html/_images/IMG_5750.jpg

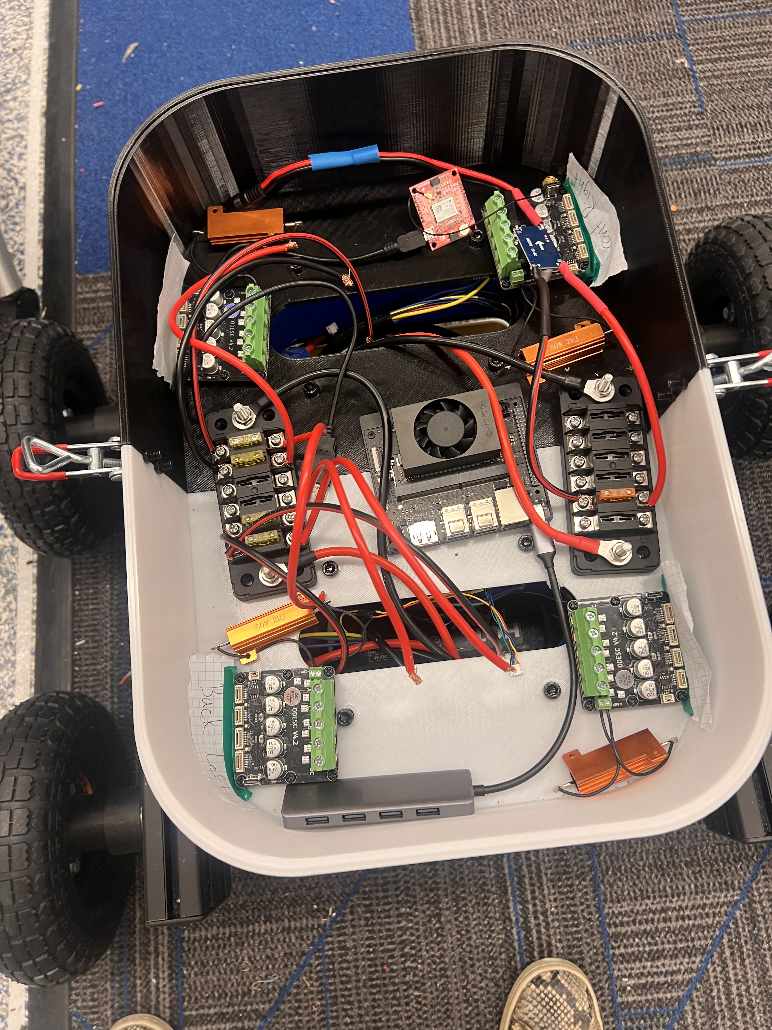
[picture p34: docs/source/_images/progress_album/IMG_5750.jpg]
docs/build/html/_images/IMG_5750.jpg
