tstrade/RoboFlock-Documentation/docs/build/html/_images/IMG_5751.jpg

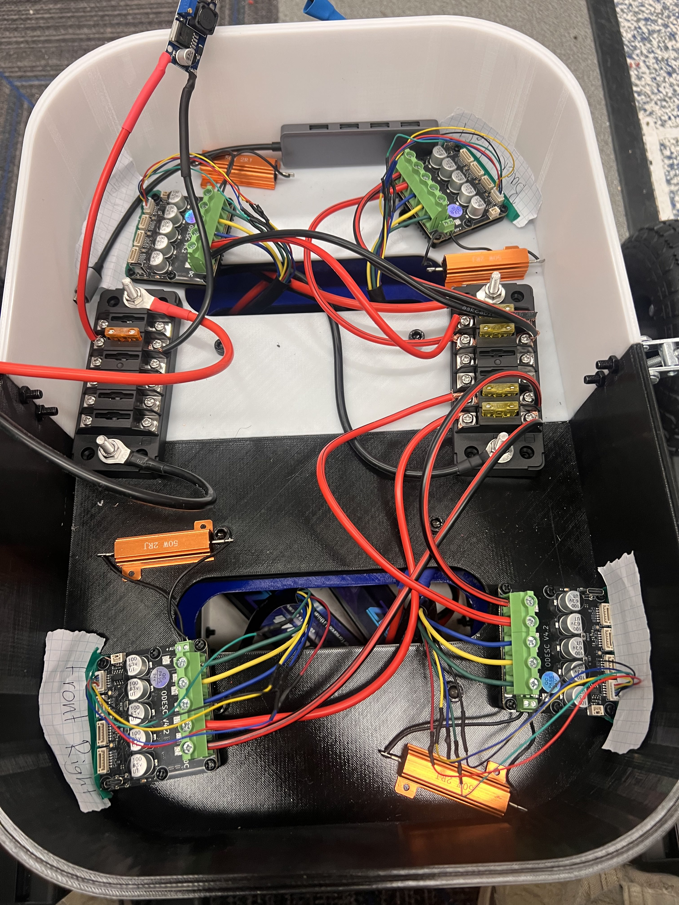
[picture p35: docs/source/_images/progress_album/IMG_5751.jpg]
docs/build/html/_images/IMG_5751.jpg
