tstrade/RoboFlock-Documentation/docs/build/html/_images/IMG_5753.jpg

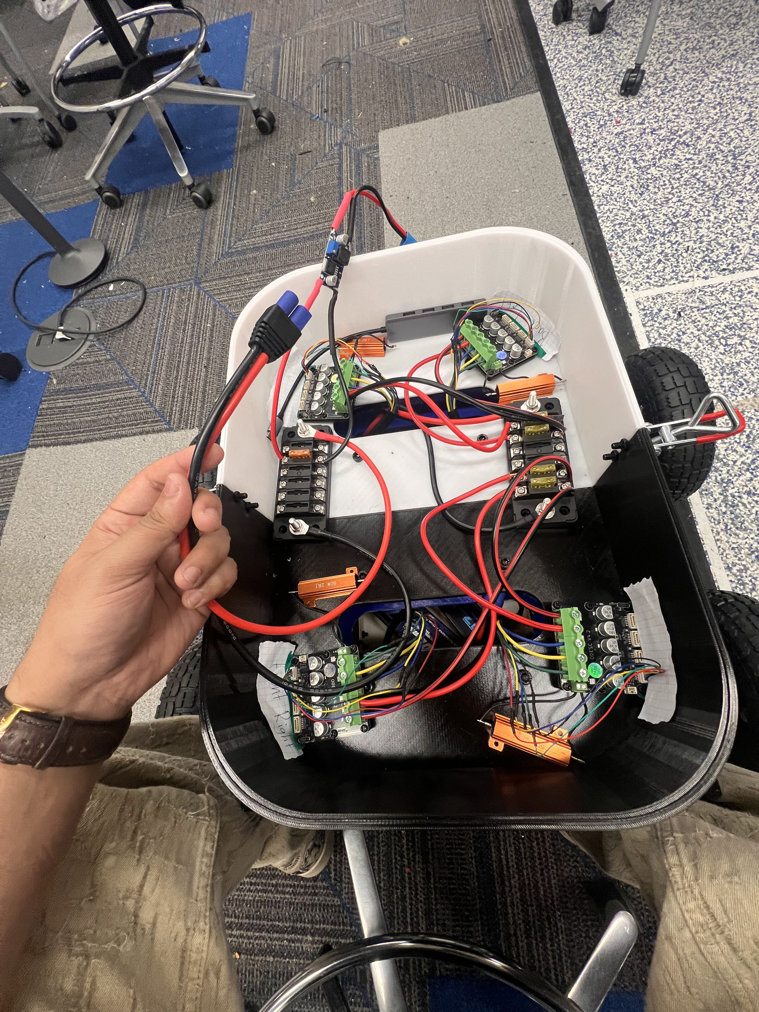
[picture p36: docs/source/_images/progress_album/IMG_5753.jpg]
docs/build/html/_images/IMG_5753.jpg
