tstrade/RoboFlock-Documentation/docs/build/html/_images/IMG_5754.jpg

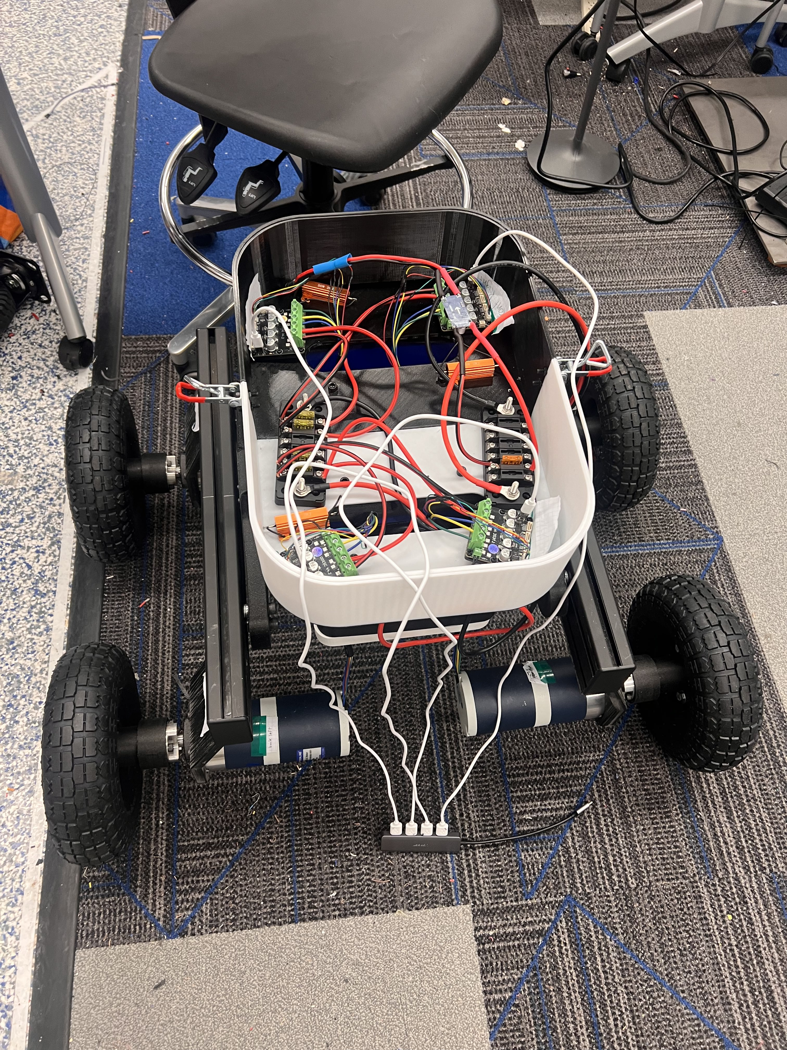
[picture p37: docs/source/_images/progress_album/IMG_5754.jpg]
docs/build/html/_images/IMG_5754.jpg
