tstrade/RoboFlock-Documentation/docs/build/html/_images/IMG_5777.jpg

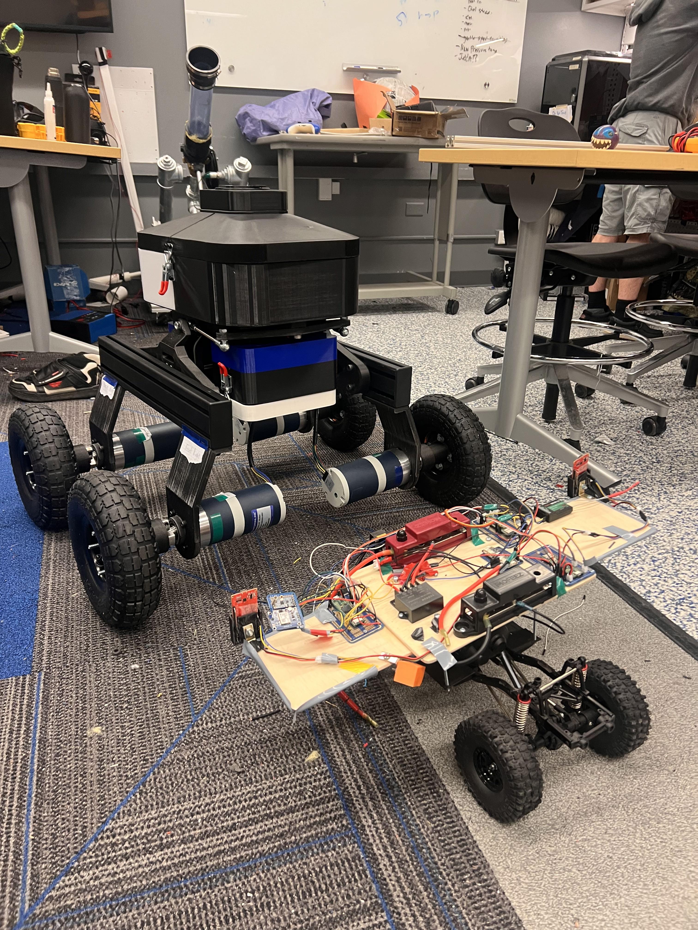
[picture p38: docs/source/_images/progress_album/IMG_5777.jpg]
docs/build/html/_images/IMG_5777.jpg
