tstrade/RoboFlock-Documentation/docs/build/html/_images/IMG_5778.jpg

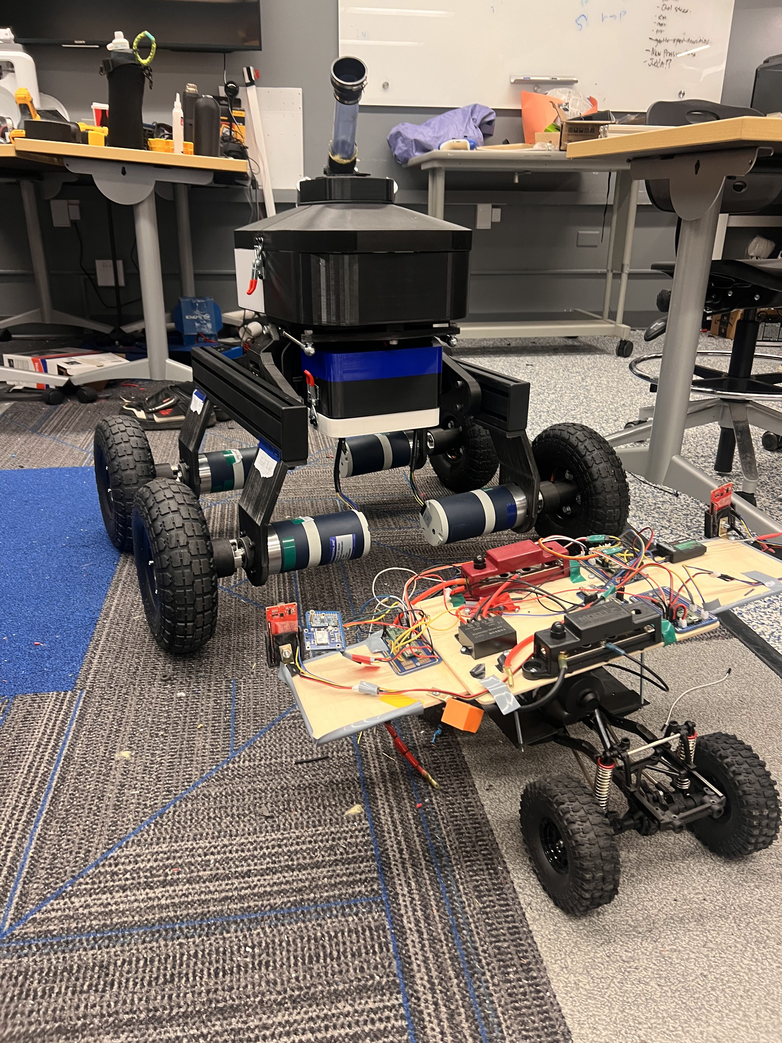
[picture p39: docs/source/_images/progress_album/IMG_5778.jpg]
docs/build/html/_images/IMG_5778.jpg
