tstrade/RoboFlock-Documentation/docs/build/html/_images/IMG_5892.jpg

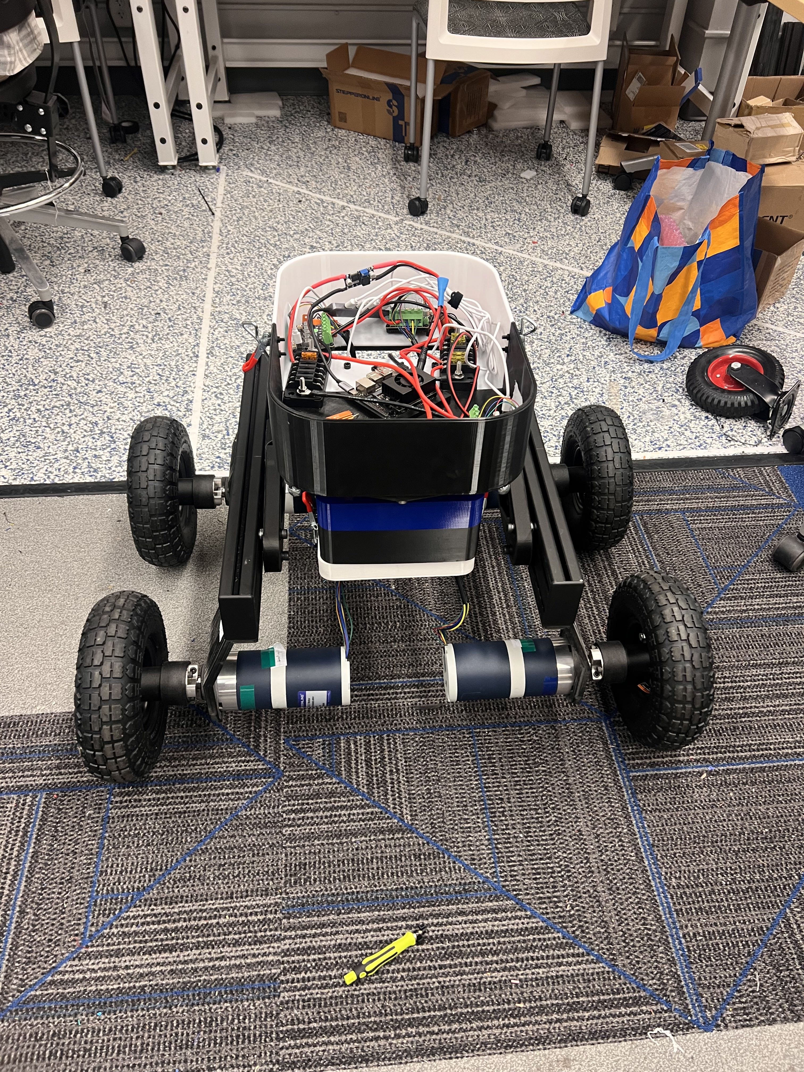
[picture p40: docs/source/_images/progress_album/IMG_5892.jpg]
docs/build/html/_images/IMG_5892.jpg
